terjeio/I2C-interface-for-4x4-keyboard/README.md

# I2C interface for 4x4 (or 5x5) keyboard with partial support for 2-key rollover and autorepeat.
Based on a Texas Instruments MSP430G2553 processor, uses a GPIO pin for signalling keypress events to host.
Example PCB is a KiCad project for the 20-pin DIP version MSP430G2553.
