terjeio/I2C-interface-for-4x4-keyboard/schematic/4x4 I2C Keyboard.kicad_pcb

## KiCad design schematic/4x4 I2C Keyboard.kicad_pcb (2017-05-16)

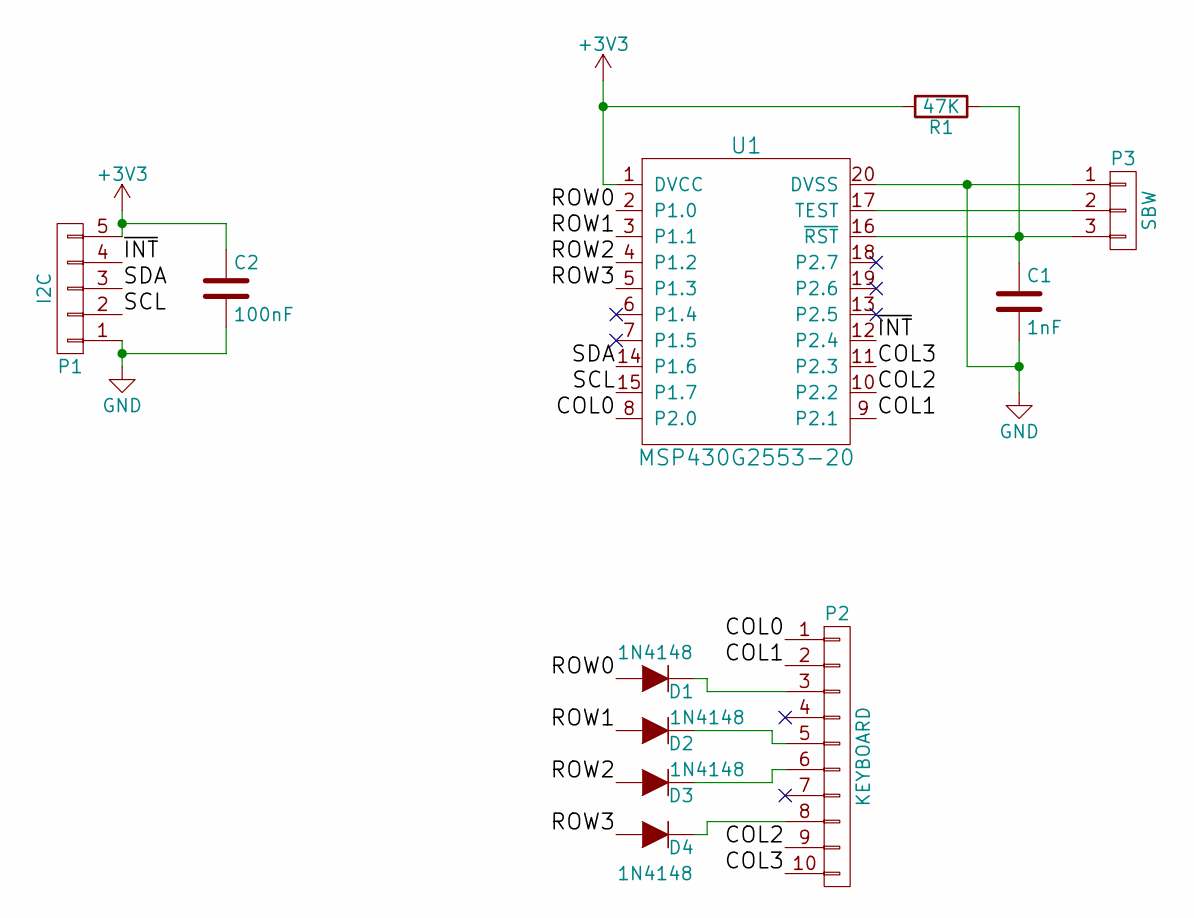
[picture p1: schematic 4x4 I2C Keyboard.sch]

Parts:
C1: 1nF; C_Disc_D5.0mm_W2.5mm_P2.50mm
C2: 100nF; C_Disc_D5.0mm_W2.5mm_P2.50mm
D1, D2, D3, D4: 1N4148; D_DO-41_SOD81_P7.62mm_Horizontal
P1: I2C; Pin_Header_Straight_1x05_Pitch2.54mm
P2: KEYBOARD; Pin_Header_Straight_1x10_Pitch2.54mm
P3: SBW; Pin_Header_Straight_1x03_Pitch2.54mm
R1: 47K; R_Axial_DIN0207_L6.3mm_D2.5mm_P10.16mm_Horizontal
U1: MSP430G2553-20; DIP-20_W7.62mm_Socket

Connections:
+3V3: C2.1, P1.5, R1.2, U1.1 (DVCC)
/COL0: P2.1, U1.8 (P2.0)
/COL1: P2.2, U1.9 (P2.1)
/COL2: P2.9, U1.10 (P2.2)
/COL3: P2.10, U1.11 (P2.3)
/ROW0: D1.2 (A), U1.2 (P1.0)
/ROW1: D2.2 (A), U1.3 (P1.1)
/ROW2: D3.2 (A), U1.4 (P1.2)
/ROW3: D4.2 (A), U1.5 (P1.3)
/SCL: P1.2, U1.15 (P1.7)
/SDA: P1.3, U1.14 (P1.6)
/~INT: P1.4, U1.12 (P2.4)
GND: C1.2, C2.2, P1.1, P3.1, U1.20 (DVSS)
unnamed: C1.1, P3.3, R1.1, U1.16 (~RST~)
unnamed: D1.1 (K), P2.3
unnamed: D2.1 (K), P2.5
unnamed: D3.1 (K), P2.6
unnamed: D4.1 (K), P2.8
unnamed: P3.2, U1.17 (TEST)

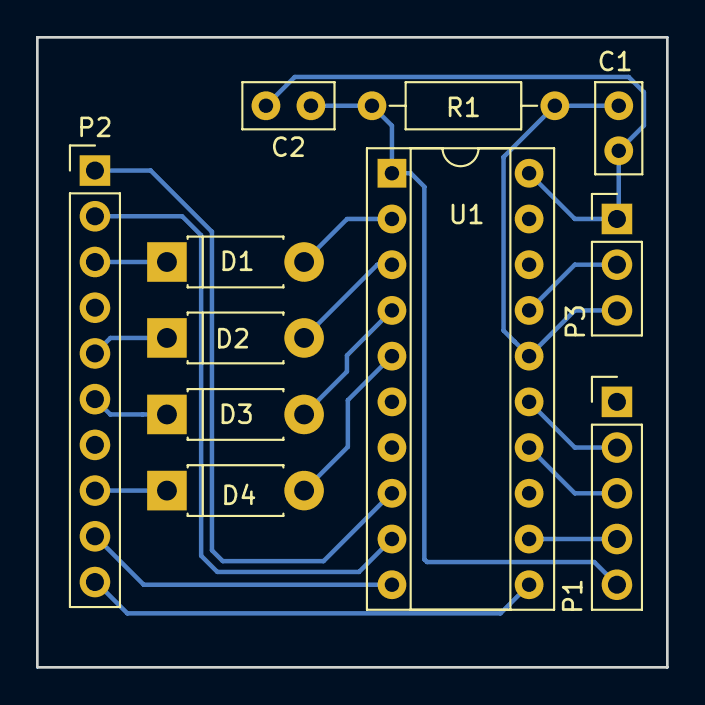
[picture p2: board 4x4 I2C Keyboard.kicad_pcb from above]

Board: 2 copper layers, 35.0 x 35.0 mm, 11 parts (0 on the bottom side), 19 nets.
