terjeio/I2C-interface-for-4x4-keyboard/(notices)

Notices in the files:
schematic/4x4 I2C Keyboard.kicad_pcb:
Licensed under CERN OHL v.1.2 or later
